FloppyO1/Floppy_Voltmeter_Clock/3D MODEL/voltmeter graphics ENG/hours.pdf

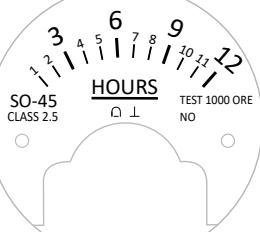
[picture p1: figure]
SO-45 CLASS 2.5; TEST 1000 ORE NO; HOURS ¹ ² 4 5
