FloppyO1/Floppy_Voltmeter_Clock/3D MODEL/voltmeter graphics ENG/minutes.pdf

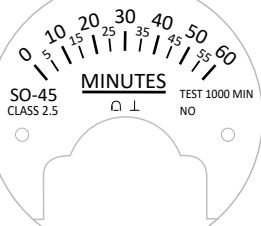
[picture p2: figure]
SO-45 CLASS 2.5; TEST 1000 MIN NO; MINUTES
