FloppyO1/Floppy_Voltmeter_Clock/3D MODEL/voltmeter graphics ITA/quadrante minuti.pdf

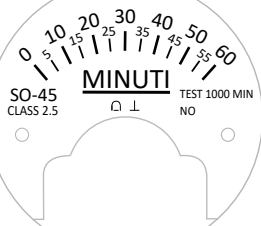
[picture p3: figure]
SO-45 CLASS 2.5; TEST 1000 MIN NO; MINUTI
