FloppyO1/Floppy_Voltmeter_Clock/3D MODEL/voltmeter graphics ITA/quadrante ore.pdf

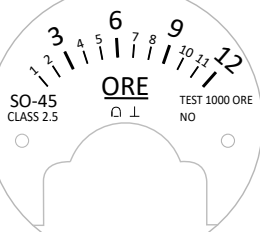
[picture p4: figure]
SO-45 CLASS 2.5; TEST 1000 ORE NO; ORE ¹ ² 4 5
