FloppyO1/Floppy_Voltmeter_Clock/3D MODEL/FVC v2.3MF

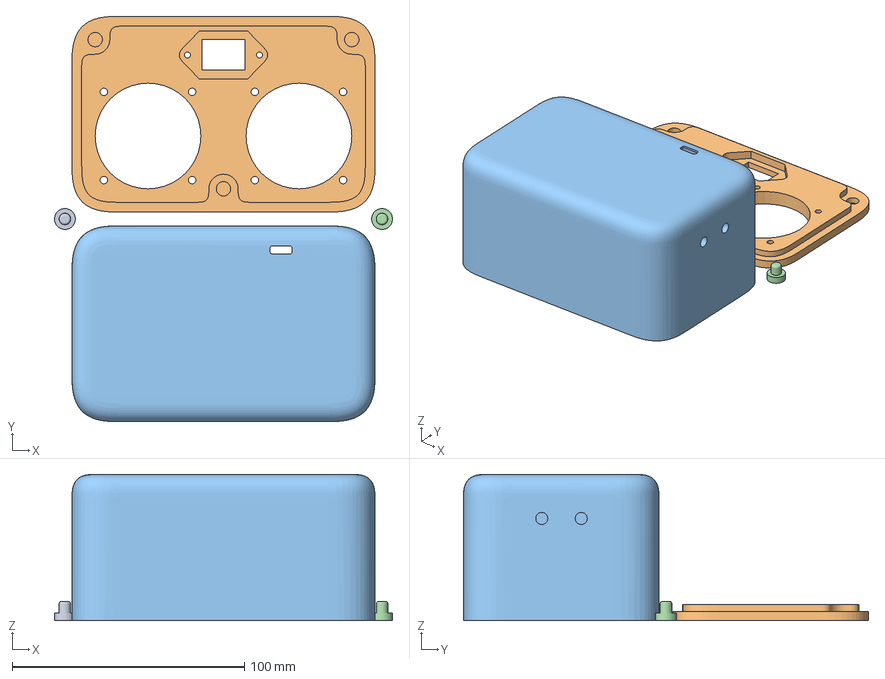
[picture p5: CAD file, 2025-03-02]
3D MODEL/FVC v2.3MF
145.6 x 174.5 x 63.0 mm
