FloppyO1/Floppy_Voltmeter_Clock/HARDWARE/Floppy voltmeter clock/Floppy voltmeter clock.step

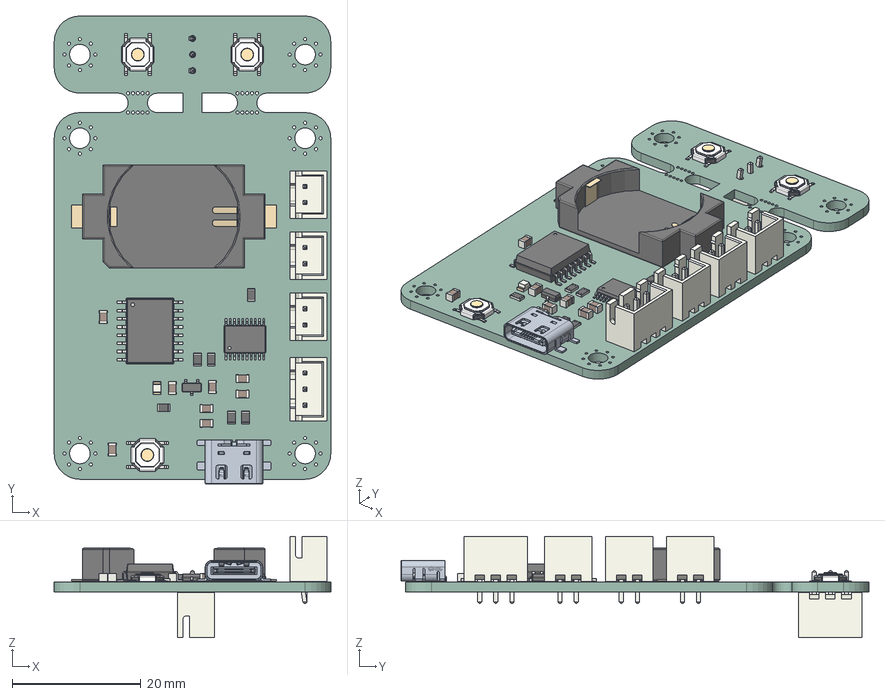
[picture p6: CAD file, 2025-01-18]
HARDWARE/Floppy voltmeter clock/Floppy voltmeter clock.step
43.0 x 72.7 x 15.7 mm
JST_B2B_XH_A x 3
USB-C 6P SMD
JST_B3B_XH_A x 2
C_0805_2012Metric x 8
TS-1187A v2 x 3
TSSOP_20_44x65mm_P065mm
SOT_23
SOIC_16W_75x103mm_P127mm
R_0805_2012Metric x 6
Keystone_1060_1x2032
LED_0805_2012Metric
Floppy voltmeter clock_PCB
