FloppyO1/Floppy_Voltmeter_Clock/HARDWARE/Floppy voltmeter clock.pdf

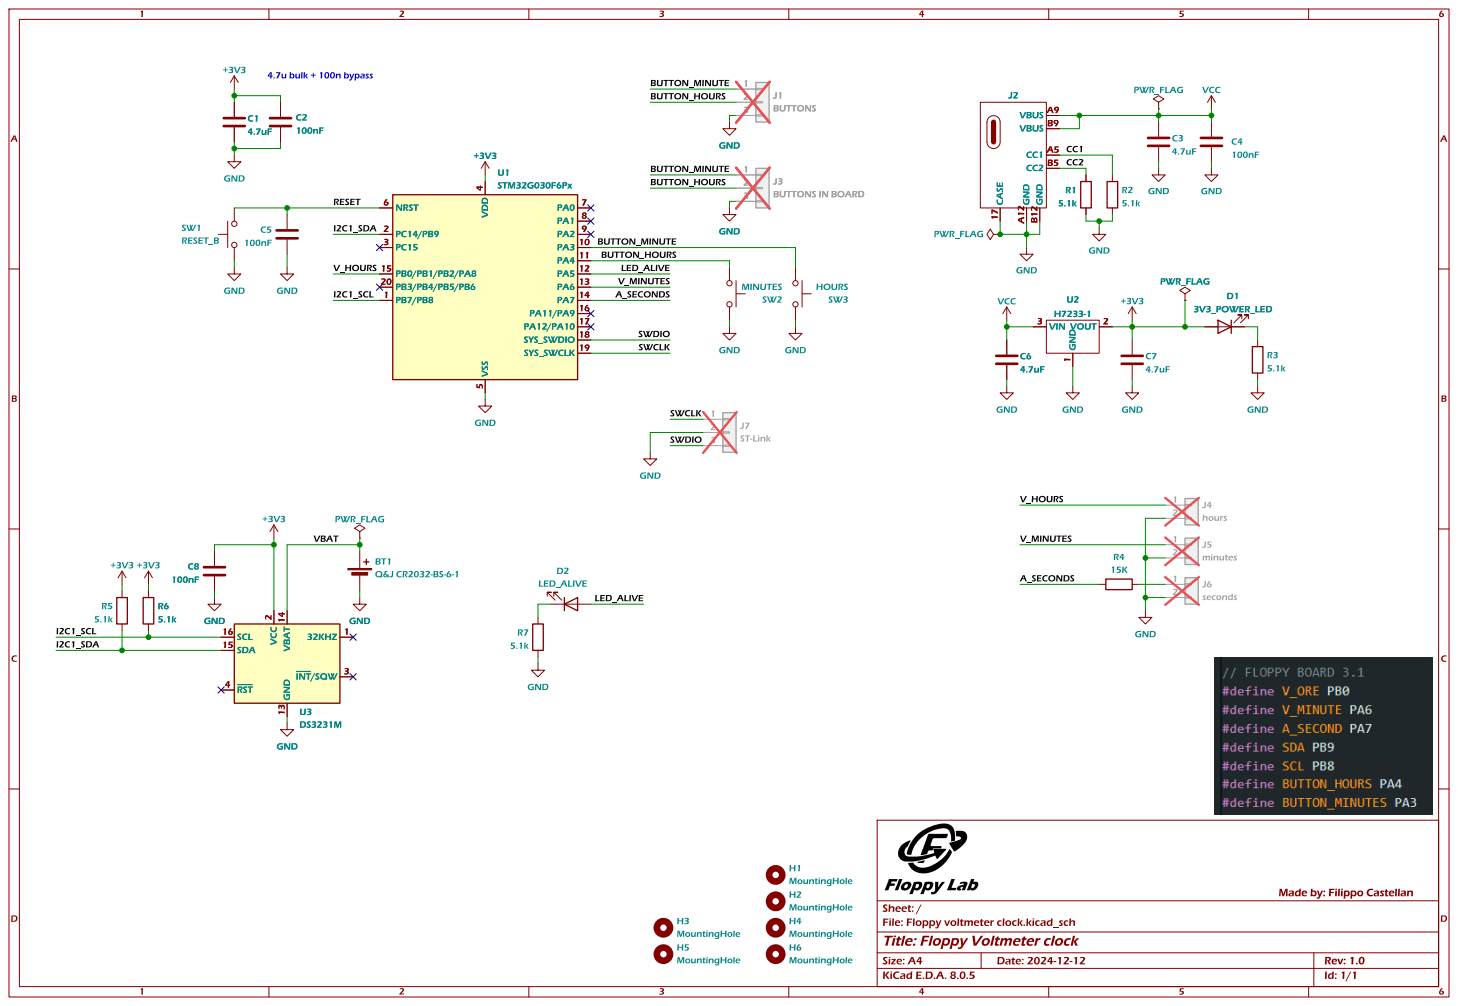
[picture p7: page 1]

Id: 1/1 Title: Floppy Voltmeter clock
