FloppyO1/Floppy_Voltmeter_Clock/HARDWARE/Floppy voltmeter clock/Floppy voltmeter clock.kicad_pcb

## KiCad design HARDWARE/Floppy voltmeter clock/Floppy voltmeter clock.kicad_pcb (2025-01-18)

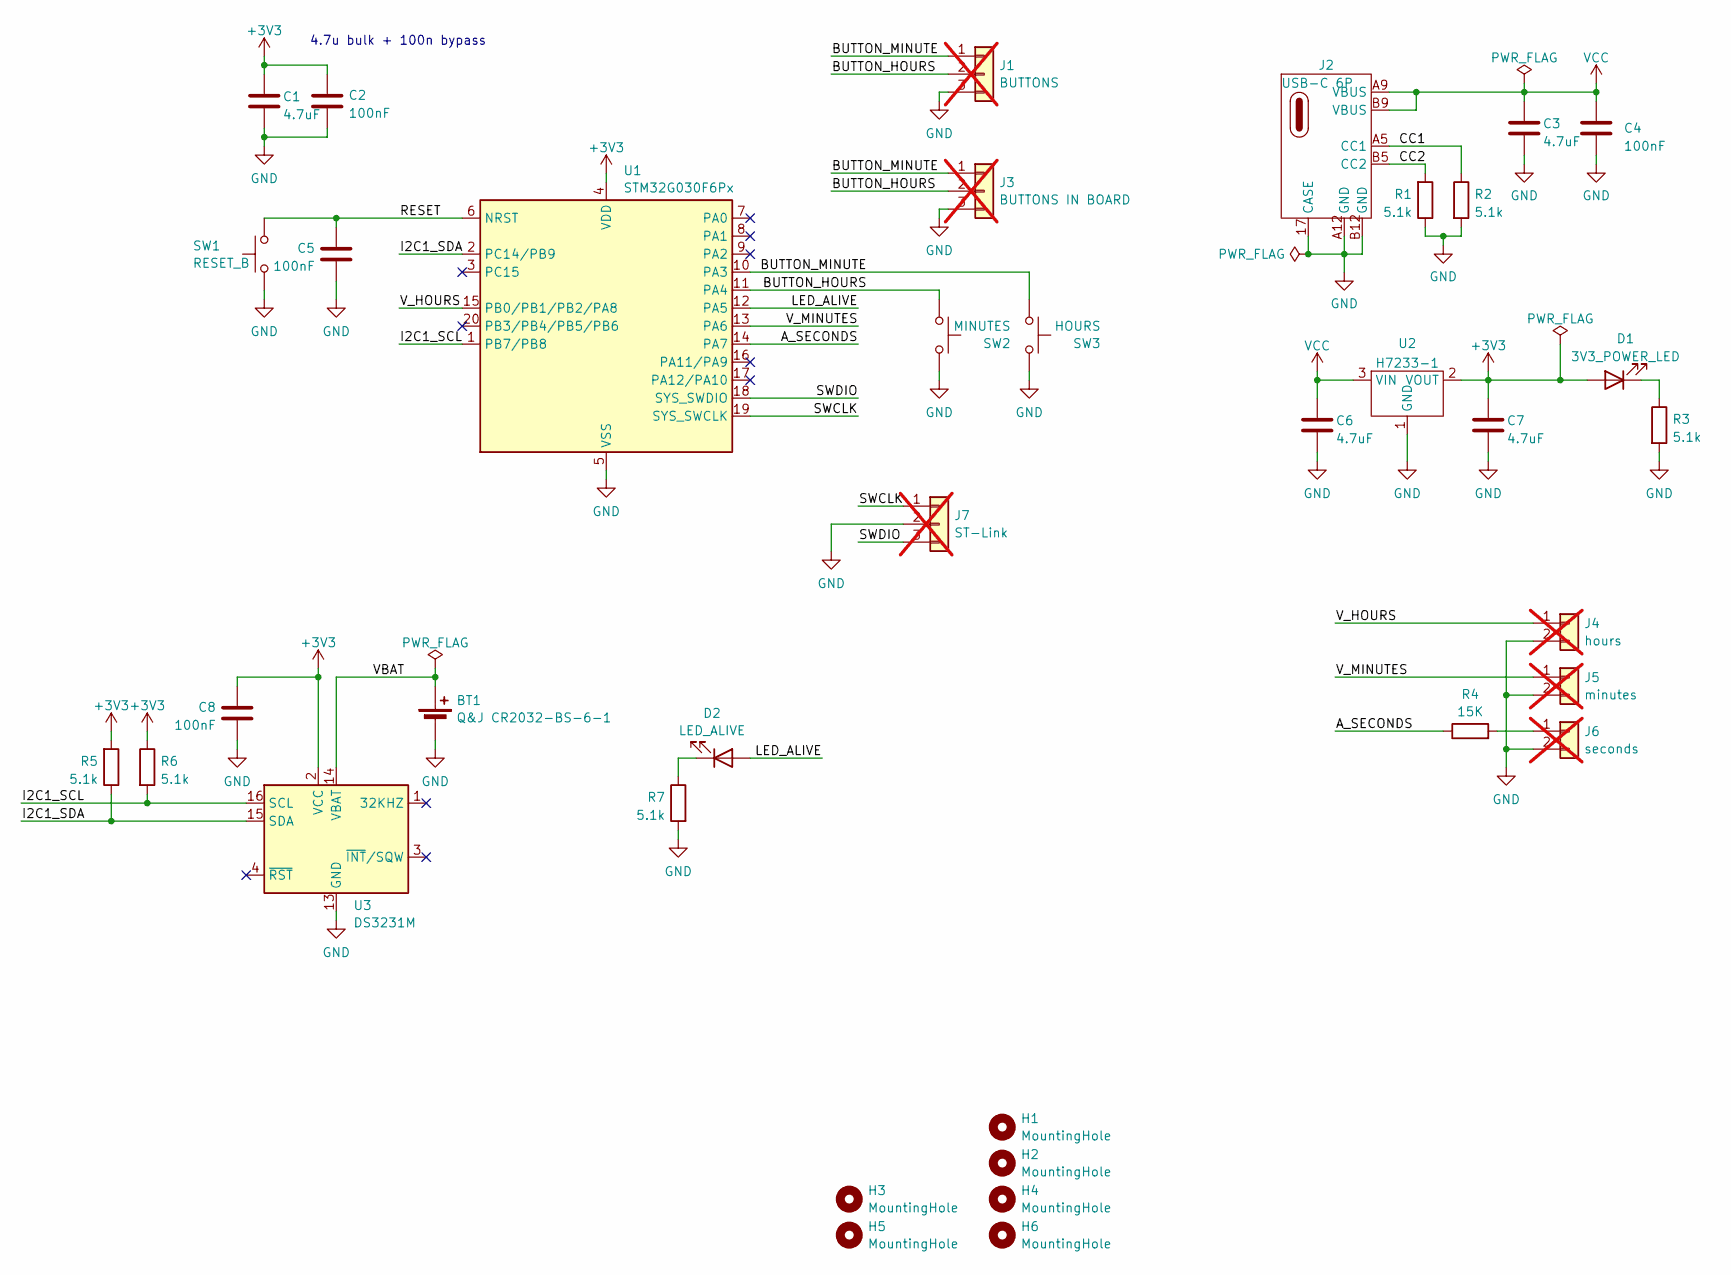
[picture p8: schematic Floppy voltmeter clock.kicad_sch]

Parts:
BT1: Q&J CR2032-BS-6-1; BatteryHolder_Keystone_1060_1x2032; LCSC C70377
C1, C3, C6, C7: 4.7uF; C_0805_2012Metric_Pad1.18x1.45mm_HandSolder; LCSC C967590
C2, C5, C8: 100nF; C_0805_2012Metric_Pad1.18x1.45mm_HandSolder; LCSC C476766
C4: 100nF; C_0805_2012Metric_Pad1.18x1.45mm_HandSolder; Voltage 50V; LCSC C476766
D1: 3V3_POWER_LED; LED_0805_2012Metric_Pad1.15x1.40mm_HandSolder; LCSC C7496834
D2: LED_ALIVE; LED_0805_2012Metric_Pad1.15x1.40mm_HandSolder; LCSC C965815
H1, H2, H3, H4, H5, H6: MountingHole; MountingHole_3.2mm_M3_Pad_Via
J1: BUTTONS; JST_XH_B3B-XH-A_1x03_P2.50mm_Vertical; LCSC C144394; not fitted
J2: USB-C 6P; USB-C (only power); LCSC C2927027
J3: BUTTONS IN BOARD; JST_XH_B3B-XH-A_1x03_P2.50mm_Vertical; LCSC C144394; not fitted
J4: hours; JST_XH_B2B-XH-A_1x02_P2.50mm_Vertical; LCSC C158012; not fitted
J5: minutes; JST_XH_B2B-XH-A_1x02_P2.50mm_Vertical; LCSC C158012; not fitted
J6: seconds; JST_XH_B2B-XH-A_1x02_P2.50mm_Vertical; LCSC C158012; not fitted
J7: ST-Link; PinHeader_1x03_P2.54mm_Vertical; not fitted
R1, R2, R3, R5, R6, R7: 5.1k; R_0805_2012Metric_Pad1.20x1.40mm_HandSolder; LCSC C23186
R4: 15K; R_0805_2012Metric_Pad1.20x1.40mm_HandSolder; LCSC C23186
SW1: RESET_B; SMD BUTTON 5.1x5.1; LCSC C318884
SW2: MINUTES; SMD BUTTON 5.1x5.1; LCSC C318884
SW3: HOURS; SMD BUTTON 5.1x5.1; LCSC C318884
U1: STM32G030F6Px; TSSOP-20_4.4x6.5mm_P0.65mm; LCSC C724040
U2: H7233-1; SOT-23; LCSC C277859
U3: DS3231M; SOIC-16W_7.5x10.3mm_P1.27mm; LCSC C9866

Connections:
+3V3: C1.1, C2.1, C7.1, C8.1, D1.2 (A), R5.2, R6.1, U1.4 (VDD), U2.2 (VOUT), U3.2 (VCC)
/A_SECONDS: R4.1, U1.14 (PA7)
/BUTTON_HOURS: J1.2, J3.2, SW2.1, U1.11 (PA4)
/BUTTON_MINUTE: J1.1, J3.1, SW3.1, U1.10 (PA3)
/CC1: J2.A5 (CC1), R2.1
/CC2: J2.B5 (CC2), R1.2
/I2C1_SCL: R6.2, U1.1 (PB7/PB8), U3.16 (SCL)
/I2C1_SDA: R5.1, U1.2 (PC14/PB9), U3.15 (SDA)
/LED_ALIVE: D2.2 (A), U1.12 (PA5)
/RESET: C5.1, SW1.2, U1.6 (NRST)
/SWCLK: J7.1, U1.19 (SYS_SWCLK)
/SWDIO: J7.3, U1.18 (SYS_SWDIO)
/VBAT: BT1.1 (+), U3.14 (VBAT)
/V_HOURS: J4.1, U1.15 (PB0/PB1/PB2/PA8)
/V_MINUTES: J5.1, U1.13 (PA6)
GND: BT1.2 (-), C1.2, C2.2, C3.2, C4.2, C5.2, C6.2, C7.2, C8.2, J1.3, J2.17 (CASE), J2.18 (CASE), J2.19 (CASE), J2.20 (CASE), J2.A12 (GND), J2.B12 (GND), J3.3, J4.2, J5.2, J6.2, J7.2, R1.1, R2.2, R3.2, R7.2, SW1.1, SW2.2, SW3.2, U1.5 (VSS), U2.1 (GND), U3.5 (GND), U3.6 (GND), U3.7 (GND), U3.8 (GND), U3.9 (GND), U3.10 (GND), U3.11 (GND), U3.12 (GND), U3.13 (GND)
unnamed: D1.1 (K), R3.1
unnamed: D2.1 (K), R7.1
unnamed: J6.1, R4.2
VCC: C3.1, C4.1, C6.1, J2.A9 (VBUS), J2.B9 (VBUS), U2.3 (VIN)

Notes on the sheet:
4.7u bulk + 100n bypass

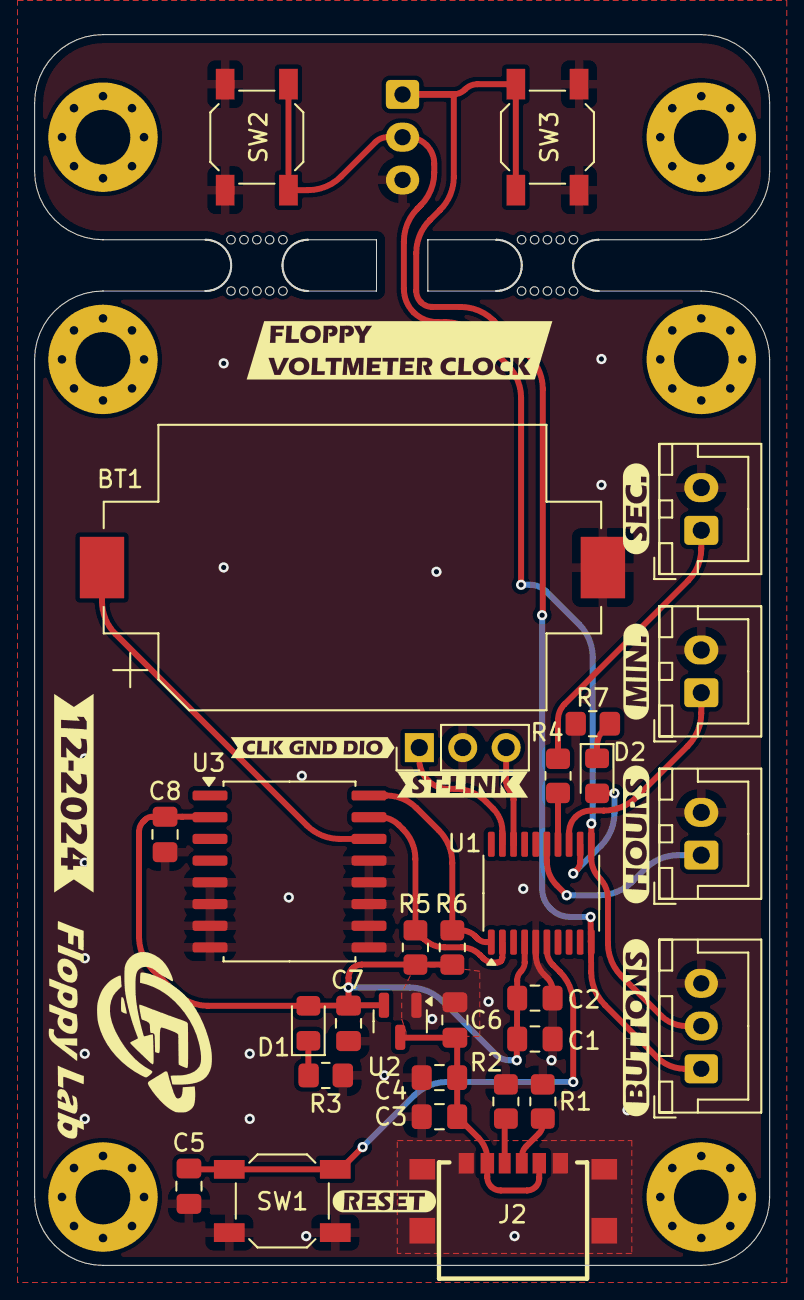
[picture p9: board Floppy voltmeter clock.kicad_pcb from above]

Board: 2 copper layers, 43.0 x 72.0 mm, 48 parts (1 on the bottom side), 20 nets.

Other parts of the board:
kibuzzard-675B2D1E: G***; kibuzzard-675B2D1E
kibuzzard-675B2D2F: G***; kibuzzard-675B2D2F
kibuzzard-675B2D7A: G***; kibuzzard-675B2D7A
kibuzzard-675B2D7E: G***; kibuzzard-675B2D7E
kibuzzard-675B2D96: G***; kibuzzard-675B2D96
kibuzzard-675B2EC4: G***; kibuzzard-675B2EC4
kibuzzard-677D17B8: G***; kibuzzard-677D17B8
kibuzzard-6786B9A9: G***; kibuzzard-6786B9A9
kibuzzard-6786B82B: G***; kibuzzard-6786B82B
mouse-bite-3mm-slot, mouse-bite-3mm-slot#2: VAL**; mouse-bite-3mm-slot
