FloppyO1/Floppy_Voltmeter_Clock/(commit log)

2025-01-20 added voltmeter custom graphics ITA/ENG
2025-01-22 Update FVC rev2.3MF
    [FVC rev2.3MF]
2025-03-02 updated 3d design (centered the seconds ampmeter)
    [FVC rev2.3MF, FVC v2.3MF]
